CanadianOrca/AV3D/README.md

# AV3D
AV3D or Avid as is our nickname, is an acoustophoretic volumetric display. It will be able to display 3D objects using acoustic radiation forces to levitate and rapidly move a small physical particle. We utilize a fast computer and synchronized LEDs to iterate a Persistence of Vision effect, making the fast bead appear 3D.
