CanadianOrca/AV3D/docs/prototype.md

Notes acquired after testing the prototype. ETA TBD.
