CanadianOrca/AV3D/bom.csv

 |  | USD
Materials List (stuff that we buy) | Amount | Cost | LINK
Pi Zero 2 W Starter Kit with Pre-Soldered Header | 1 | $117.62 | https://www.canakit.com/raspberry-pi-zero-2-w.html?cid=cad&src=raspberrypi
1?20 female header, 2.54 mm PPTC201LFBN-RC | 4 | $3.24 | https://www.digikey.ca/en/products/detail/sullins-connector-solutions/PPTC201LFBN-RC/810158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
Sipeed Tang Nano 20K FPGA board (GW2AR-18), (with soldered pin header) | 3 | $80.02 | https://www.aliexpress.com/item/1005005581148230.html
Mean Well GST160A12-R7B, 12 V 11.5 A 138 W desktop adapter, 4-pin DIN (R7B) output, C14 inlet | 1 | $53.05 | https://www.digikey.ca/en/products/detail/mean-well-usa-inc/GST160A12-R7B/7703599
Mean Well DC-PLUG-R7BF-P1M (R7B to 5.5 ? 2.5 mm plug adapter) | 1 | $1.21 | https://www.digikey.ca/en/products/detail/mean-well-usa-inc/DC-PLUG-R7BF-P1M/12142223
DC jack to screw terminal adapter, 5.5 ? 2.5 mm male/female | 1 | $8.51 | https://www.amazon.ca/20-Connectors-Terminal-Adapter-Security/dp/B0C4JJ2HB4/ref=sr_1_7?sr=8-7
TED-LED 12 pcs 5 x 20 mm inline screw-type fuse holders with 16 AWG wire + fuse kit | 1 | $9.90 | https://www.amazon.ca/Ted-Lele-5x20mm-Holder-Assorted/dp/B07BC8DW3L/ref=sr_1_9?sr=8-9
Phoenix Contact 1715721 (MKDS 1,5/2-5,08), 2-pos 10 A 5.08 mm 2 pin PCB screw terminal, J1 | 2 | $2.37 | https://www.mouser.ca/ProductDetail/Phoenix-Contact/1715721?qs=BYlwlsDsB%2FqgmKyTCSucHg%3D%3D
DC Y-splitter, 5.5 ? 2.5 mm, 10A, 1 female to 2 male | 1 | $4.13 | https://www.aliexpress.com/i/1005012828857964.html
BOJACK T5AL250V, 5 A time-lag 5 x 20 mm slow-blow glass fuses | 1 | $11.35 | https://www.amazon.ca/BOJACK-T5AL250V-5x20mm-Fuses-Time-delay/dp/B07XYWZWV4/ref=sr_1_6?sr=8-6
Nichicon UHE1E471MPD6, 470 æF 25 V electrolytic, 10 mm | 6 | $4.87 | https://www.digikey.ca/en/products/detail/nichicon/UHE1E471MPD6/589294
Amazon basics AC NEMA 5-15P to IEC C13, 6 ft power cord | 1 | $8.95 | https://www.amazon.ca/Amazon-Basics-Computer-Monitor-Replacement/dp/B072BYGKZZ
3W RGB LED 6PIN | 6 | $1.21 | https://www.aliexpress.com/item/1005011863414612.html
Phoenix Contact 1715747 (MKDS 1,5/4-5,08) 4-pin 5.08 mm screw terminal J6 | 1 | $2.33 | https://www.mouser.ca/en/ProductDetail/Phoenix-Contact/1715747
through-hole resistor (Vishay PR02000202709JR500, 27 ê 2 W red, R19) | 2 | $0.88 | https://www.digikey.ca/en/products/detail/vishay-beyschlag-draloric-bc-components/PR02000202709JR500/596160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
through-hole resistor( Vishay PR02000201209JR500, 12 ê 2 W green and blue, R20/R21) | 4 | $1.65 | https://www.digikey.ca/en/products/result?keywords=PR02000201209JR500
Standoffs and M3 screws and nuts | 1 | $12.77 | https://www.amazon.ca/Jucoan-Standoffs-Assortment-Threaded-Motherboard/dp/B08DMSNB8X
Clear plastic shield clear acrylic sheet 2mm | 3 | $14.19 | https://www.amazon.ca/Acrylic-Transparent-Plexiglass-Protective-Projects/dp/B09XR5MR17
Fermerry 22 10ft AWG Hook-up wire, 6 colours each | 1 | $14.41 | https://www.amazon.ca/Fermerry-Stranded-Electric-Tinned-Copper/dp/B089CQHRDT
18 AWG red/black wire | 1 | $12.77 | https://www.amazon.ca/VIABRICO-Electrical-Stranded-Voltage-Extension/dp/B08D6VND2B
Female-to-female jumper wires | 1 | $4.96 | https://www.amazon.ca/Elegoo-120pcs-Multicolored-Breadboard-arduino/dp/B0H6F428L1
Break-away 0.1" 36-pin strip male header (J3, J4, J5, J7, J8) | 1 | $4.93 | https://www.pishop.ca/product/break-away-0-1-36-pin-strip-male-header-10-pieces/
2.54 mm jumper shunt (J7, J8) | 1 | $6.38 | https://www.amazon.ca/MECCANIXITY-2-54mm-Standard-Circuit-Connection/dp/B0BG9VL1SL/ref=sr_1_5?sr=8-5
10mm 40kHz Piezo Ultrasonic Transmitter Manorshi MSO-P1Z1040DH07T (Sound) | 288 | $189.45 | https://www.alibaba.com/product-detail/Manorshi_10mm_40khz_piezo_ultrasonic_Transmitter_Receiver_sensor_60248714908.html
polysterene beads 2-3 mm | 1 | $11.21 | https://www.amazon.ca/PATIKIL-Polystyrene-Supplies-Wedding-Homemade/dp/B0FC2DBFSL/ref=sr_1_2?sr=8-2
PCB | 2 | $350.00 | https://jlcpcb.com/user-center/orderDetails/?batchNum=W2026111010204639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
Total cost in USD |  | $932.30
Recommended Budget: |  | $1,000
