CanadianOrca/AV3D/cad/Hackclubprototype.step

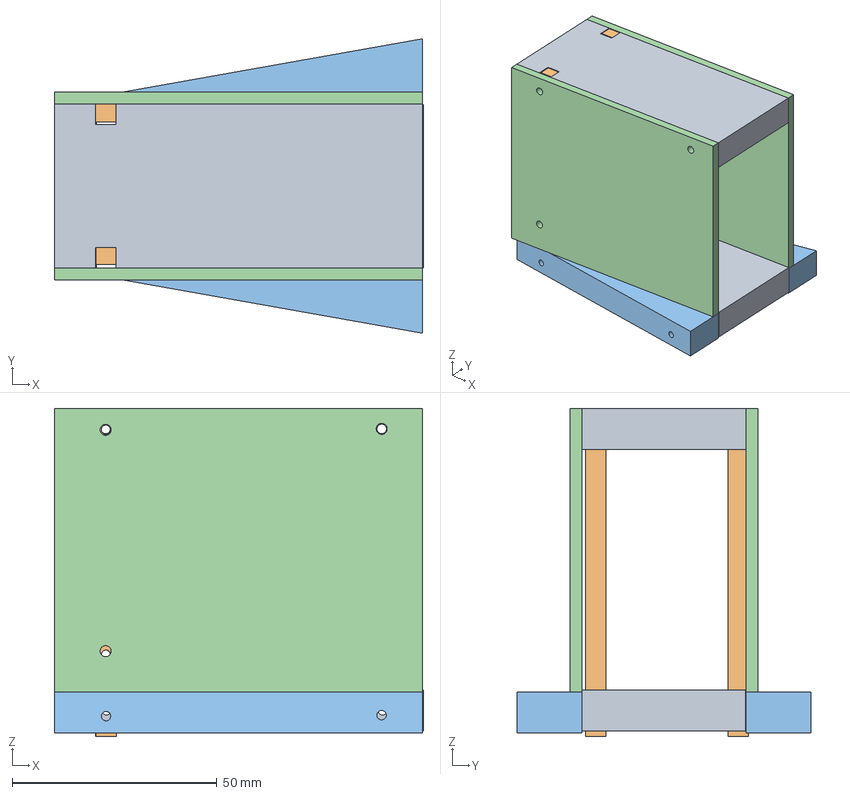
[picture p1: CAD file, 2026-11-12]
cad/Hackclubprototype.step
90.2 x 72.0 x 80.2 mm
