CanadianOrca/AV3D/hardware/kicad/AV3D PC.kicad_pcb

## KiCad design hardware/kicad/AV3D PC.kicad_pcb (2026-11-12)

Schematic: AV3D PCB.kicad_sch

Parts:
A1: Raspberry Pi Zero 2 W; Raspberry_Pi_Zero_Socketed_THT_MountingHoles_SMT
A2: Tang Nano 20K; TangNano20K_2x20
C1, C2, C3, C4, C5, C6, C7, C8, C9, C10, C11, C12, C13, C14, C15, C16, C17, C18, C19, C20, C21, C22, C23, C24, C25, C26, C27, C28, C29, C30, C31, C32, C33, C34, C35, C36, C37, C38, C39, C40, C41, C42, C43, C44, C45, C46, C47, C48, C49, C50, C51, C52, C53, C54, C55, C56, C57, C58, C59, C60, C61, C62, C63, C64, C65, C66, C67, C68, C69, C70, C71, C72, C73, C74, C75, C76, C77, C78, C79, C80, C81, C82, C83, C84, C85, C86, C87, C88, C89, C90, C91, C92, C93, C94, C95, C96, C97, C98, C99, C100, C101, C102, C103, C104, C105, C106, C107, C108, C109, C110, C111, C112, C113, C114, C115, C116, C117, C118, C119, C120, C121, C122, C123, C124, C125, C126, C127, C128, C129, C130, C131, C132, C133, C134, C135, C136, C137, C138, C139, C140, C141, C142, C143, C144: 4.7uF, 35V; C_1206_3216Metric
C145, C146, C147, C148, C149, C150, C151, C152, C153, C154, C155, C156, C157, C158, C159, C160, C161, C162, C163, C164, C165, C166, C167, C168, C169, C170, C171, C172, C173, C174, C175, C176, C177, C178, C179, C180, C181, C182, C183, C184, C185, C186, C187, C188, C189, C190, C191, C192, C193, C194, C195, C196, C197, C198, C199, C200, C201, C202, C203, C204, C205, C206, C207, C208, C209, C210, C211, C212, C213, C214, C215, C216, C217, C218, C219, C220, C221, C222, C223, C224, C225, C226, C227, C228, C229, C230, C231, C232, C233, C234, C235, C236, C237, C238, C239, C240, C241, C242, C243, C244, C245, C246, C247, C248, C249, C250, C251, C252, C253, C254, C255, C256, C257, C258, C259, C260, C261, C262, C263, C264, C265, C266, C267, C268, C269, C270, C271, C272, C273, C274, C275, C276, C277, C278, C279, C280, C281, C282, C283, C284, C285, C286, C287, C288, C289, C290, C291, C292, C293, C294, C295, C296, C297, C298, C299, C300, C301, C302, C303, C304, C305, C306: 0.1uF, 35V; C_0805_2012Metric
D1: 1N5819WS; D_SOD-123
J1: 12V IN; Molex_70555_RA_1x02_P2.54
J2: LED 1 (12V common anode); PinHeader_1x04_P2.54mm_Vertical
J3: LED 2 (12V common anode); PinHeader_1x04_P2.54mm_Vertical
J4: LED 3 (12V common anode); PinHeader_1x04_P2.54mm_Vertical
J5: LED 4 (12V common anode); PinHeader_1x04_P2.54mm_Vertical
J6: BOARD LINK; PinHeader_1x06_P2.54mm_Vertical
J7: 5V IN; PinHeader_1x02_P2.54mm_Vertical
LS1, LS2, LS3, LS4, LS5, LS6, LS7, LS8, LS9, LS10, LS11, LS12, LS13, LS14, LS15, LS16, LS17, LS18, LS19, LS20, LS21, LS22, LS23, LS24, LS25, LS26, LS27, LS28, LS29, LS30, LS31, LS32, LS33, LS34, LS35, LS36, LS37, LS38, LS39, LS40, LS41, LS42, LS43, LS44, LS45, LS46, LS47, LS48, LS49, LS50, LS51, LS52, LS53, LS54, LS55, LS56, LS57, LS58, LS59, LS60, LS61, LS62, LS63, LS64, LS65, LS66, LS67, LS68, LS69, LS70, LS71, LS72, LS73, LS74, LS75, LS76, LS77, LS78, LS79, LS80, LS81, LS82, LS83, LS84, LS85, LS86, LS87, LS88, LS89, LS90, LS91, LS92, LS93, LS94, LS95, LS96, LS97, LS98, LS99, LS100, LS101, LS102, LS103, LS104, LS105, LS106, LS107, LS108, LS109, LS110, LS111, LS112, LS113, LS114, LS115, LS116, LS117, LS118, LS119, LS120, LS121, LS122, LS123, LS124, LS125, LS126, LS127, LS128, LS129, LS130, LS131, LS132, LS133, LS134, LS135, LS136, LS137, LS138, LS139, LS140, LS141, LS142, LS143, LS144: Speaker_Ultrasound; MSO-P1040H07T
Q1, Q2, Q3: AO3400A; SOT-23
R1, R2: 10k; R_0603_1608Metric
R3, R4, R5, R6, R7: 100; R_0603_1608Metric
R8, R9, R10: 100k; R_0603_1608Metric
U1, U2, U3, U4, U5, U6, U7, U8, U9, U10, U11, U12, U13, U14, U15, U16, U17, U18, U19, U20, U21, U22, U23, U24, U25, U26, U27, U28, U29, U30, U31, U32, U33, U34, U35, U36, U37, U38, U39, U40, U41, U42, U43, U44, U45, U46, U47, U48, U49, U50, U51, U52, U53, U54, U55, U56, U57, U58, U59, U60, U61, U62, U63, U64, U65, U66, U67, U68, U69, U70, U71, U72, U73, U74, U75, U76, U77, U78, U79, U80, U81, U82, U83, U84, U85, U86, U87, U88, U89, U90, U91, U92, U93, U94, U95, U96, U97, U98, U99, U100, U101, U102, U103, U104, U105, U106, U107, U108, U109, U110, U111, U112, U113, U114, U115, U116, U117, U118, U119, U120, U121, U122, U123, U124, U125, U126, U127, U128, U129, U130, U131, U132, U133, U134, U135, U136, U137, U138, U139, U140, U141, U142, U143, U144: TC4428A; SO-8_3.9x4.9mm_P1.27mm
U145, U146, U147, U148, U149, U150, U151, U152, U153, U154, U155, U156, U157, U158, U159, U160, U161, U162: 74AHC595; SOIC-16_3.9x9.9mm_P1.27mm

Connections:
+3V3: A2.16 (J5-16 3V3), A2.39 (J6-19 3V3), C289.1, C290.1, C291.1, C292.1, C293.1, C294.1, C295.1, C296.1, C297.1, C298.1, C299.1, C300.1, C301.1, C302.1, C303.1, C304.1, C305.1, C306.1, R1.1, R2.1, U145.10 (~SRCLR), U145.16 (VCC), U146.10 (~SRCLR), U146.16 (VCC), U147.10 (~SRCLR), U147.16 (VCC), U148.10 (~SRCLR), U148.16 (VCC), U149.10 (~SRCLR), U149.16 (VCC), U150.10 (~SRCLR), U150.16 (VCC), U151.10 (~SRCLR), U151.16 (VCC), U152.10 (~SRCLR), U152.16 (VCC), U153.10 (~SRCLR), U153.16 (VCC), U154.10 (~SRCLR), U154.16 (VCC), U155.10 (~SRCLR), U155.16 (VCC), U156.10 (~SRCLR), U156.16 (VCC), U157.10 (~SRCLR), U157.16 (VCC), U158.10 (~SRCLR), U158.16 (VCC), U159.10 (~SRCLR), U159.16 (VCC), U160.10 (~SRCLR), U160.16 (VCC), U161.10 (~SRCLR), U161.16 (VCC), U162.10 (~SRCLR), U162.16 (VCC)
+5V: A1.2 (5V), A1.4 (5V), D1.2 (A), J7.1
+5V_TANG: A2.1 (J5-1 5V), D1.1 (K)
+12V: C1.1, C2.1, C3.1, C4.1, C5.1, C6.1, C7.1, C8.1, C9.1, C10.1, C11.1, C12.1, C13.1, C14.1, C15.1, C16.1, C17.1, C18.1, C19.1, C20.1, C21.1, C22.1, C23.1, C24.1, C25.1, C26.1, C27.1, C28.1, C29.1, C30.1, C31.1, C32.1, C33.1, C34.1, C35.1, C36.1, C37.1, C38.1, C39.1, C40.1, C41.1, C42.1, C43.1, C44.1, C45.1, C46.1, C47.1, C48.1, C49.1, C50.1, C51.1, C52.1, C53.1, C54.1, C55.1, C56.1, C57.1, C58.1, C59.1, C60.1, C61.1, C62.1, C63.1, C64.1, C65.1, C66.1, C67.1, C68.1, C69.1, C70.1, C71.1, C72.1, C73.1, C74.1, C75.1, C76.1, C77.1, C78.1, C79.1, C80.1, C81.1, C82.1, C83.1, C84.1, C85.1, C86.1, C87.1, C88.1, C89.1, C90.1, C91.1, C92.1, C93.1, C94.1, C95.1, C96.1, C97.1, C98.1, C99.1, C100.1, C101.1, C102.1, C103.1, C104.1, C105.1, C106.1, C107.1, C108.1, C109.1, C110.1, C111.1, C112.1, C113.1, C114.1, C115.1, C116.1, C117.1, C118.1, C119.1, C120.1, C121.1, C122.1, C123.1, C124.1, C125.1, C126.1, C127.1, C128.1, C129.1, C130.1, C131.1, C132.1, C133.1, C134.1, C135.1, C136.1, C137.1, C138.1, C139.1, C140.1, C141.1, C142.1, C143.1, C144.1, C145.1, C146.1, C147.1, C148.1, C149.1, C150.1, C151.1, C152.1, C153.1, C154.1, C155.1, C156.1, C157.1, C158.1, C159.1, C160.1, C161.1, C162.1, C163.1, C164.1, C165.1, C166.1, C167.1, C168.1, C169.1, C170.1, C171.1, C172.1, C173.1, C174.1, C175.1, C176.1, C177.1, C178.1, C179.1, C180.1, C181.1, C182.1, C183.1, C184.1, C185.1, C186.1, C187.1, C188.1, C189.1, C190.1, C191.1, C192.1, C193.1, C194.1, C195.1, C196.1, C197.1, C198.1, C199.1, C200.1, C201.1, C202.1, C203.1, C204.1, C205.1, C206.1, C207.1, C208.1, C209.1, C210.1, C211.1, C212.1, C213.1, C214.1, C215.1, C216.1, C217.1, C218.1, C219.1, C220.1, C221.1, C222.1, C223.1, C224.1, C225.1, C226.1, C227.1, C228.1, C229.1, C230.1, C231.1, C232.1, C233.1, C234.1, C235.1, C236.1, C237.1, C238.1, C239.1, C240.1, C241.1, C242.1, C243.1, C244.1, C245.1, C246.1, C247.1, C248.1, C249.1, C250.1, C251.1, C252.1, C253.1, C254.1, C255.1, C256.1, C257.1, C258.1, C259.1, C260.1, C261.1, C262.1, C263.1, C264.1, C265.1, C266.1, C267.1, C268.1, C269.1, C270.1, C271.1, C272.1, C273.1, C274.1, C275.1, C276.1, C277.1, C278.1, C279.1, C280.1, C281.1, C282.1, C283.1, C284.1, C285.1, C286.1, C287.1, C288.1, J1.1, J2.1, J3.1, J4.1, J5.1, U1.6 (VDD), U2.6 (VDD), U3.6 (VDD), U4.6 (VDD), U5.6 (VDD), U6.6 (VDD), U7.6 (VDD), U8.6 (VDD), U9.6 (VDD), U10.6 (VDD), U11.6 (VDD), U12.6 (VDD), U13.6 (VDD), U14.6 (VDD), U15.6 (VDD), U16.6 (VDD), U17.6 (VDD), U18.6 (VDD), U19.6 (VDD), U20.6 (VDD), U21.6 (VDD), U22.6 (VDD), U23.6 (VDD), U24.6 (VDD), U25.6 (VDD), U26.6 (VDD), U27.6 (VDD), U28.6 (VDD), U29.6 (VDD), U30.6 (VDD), U31.6 (VDD), U32.6 (VDD), U33.6 (VDD), U34.6 (VDD), U35.6 (VDD), U36.6 (VDD), U37.6 (VDD), U38.6 (VDD), U39.6 (VDD), U40.6 (VDD), U41.6 (VDD), U42.6 (VDD), U43.6 (VDD), U44.6 (VDD), U45.6 (VDD), U46.6 (VDD), U47.6 (VDD), U48.6 (VDD), U49.6 (VDD), U50.6 (VDD), U51.6 (VDD), U52.6 (VDD), U53.6 (VDD), U54.6 (VDD), U55.6 (VDD), U56.6 (VDD), U57.6 (VDD), U58.6 (VDD), U59.6 (VDD), U60.6 (VDD), U61.6 (VDD), U62.6 (VDD), U63.6 (VDD), U64.6 (VDD), U65.6 (VDD), U66.6 (VDD), U67.6 (VDD), U68.6 (VDD), U69.6 (VDD), U70.6 (VDD), U71.6 (VDD), U72.6 (VDD), U73.6 (VDD), U74.6 (VDD), U75.6 (VDD), U76.6 (VDD), U77.6 (VDD), U78.6 (VDD), U79.6 (VDD), U80.6 (VDD), U81.6 (VDD), U82.6 (VDD), U83.6 (VDD), U84.6 (VDD), U85.6 (VDD), U86.6 (VDD), U87.6 (VDD), U88.6 (VDD), U89.6 (VDD), U90.6 (VDD), U91.6 (VDD), U92.6 (VDD), U93.6 (VDD), U94.6 (VDD), U95.6 (VDD), U96.6 (VDD), U97.6 (VDD), U98.6 (VDD), U99.6 (VDD), U100.6 (VDD), U101.6 (VDD), U102.6 (VDD), U103.6 (VDD), U104.6 (VDD), U105.6 (VDD), U106.6 (VDD), U107.6 (VDD), U108.6 (VDD), U109.6 (VDD), U110.6 (VDD), U111.6 (VDD), U112.6 (VDD), U113.6 (VDD), U114.6 (VDD), U115.6 (VDD), U116.6 (VDD), U117.6 (VDD), U118.6 (VDD), U119.6 (VDD), U120.6 (VDD), U121.6 (VDD), U122.6 (VDD), U123.6 (VDD), U124.6 (VDD), U125.6 (VDD), U126.6 (VDD), U127.6 (VDD), U128.6 (VDD), U129.6 (VDD), U130.6 (VDD), U131.6 (VDD), U132.6 (VDD), U133.6 (VDD), U134.6 (VDD), U135.6 (VDD), U136.6 (VDD), U137.6 (VDD), U138.6 (VDD), U139.6 (VDD), U140.6 (VDD), U141.6 (VDD), U142.6 (VDD), U143.6 (VDD), U144.6 (VDD)
CH1: U1.2 (INA), U1.4 (INB), U145.15 (QA)
CH2: U2.2 (INA), U2.4 (INB), U145.1 (QB)
CH3: U3.2 (INA), U3.4 (INB), U145.2 (QC)
CH4: U4.2 (INA), U4.4 (INB), U145.3 (QD)
CH5: U5.2 (INA), U5.4 (INB), U145.4 (QE)
CH6: U6.2 (INA), U6.4 (INB), U145.5 (QF)
CH7: U7.2 (INA), U7.4 (INB), U145.6 (QG)
CH8: U8.2 (INA), U8.4 (INB), U145.7 (QH)
CH9: U9.2 (INA), U9.4 (INB), U146.15 (QA)
CH10: U10.2 (INA), U10.4 (INB), U146.1 (QB)
CH11: U11.2 (INA), U11.4 (INB), U146.2 (QC)
CH12: U12.2 (INA), U12.4 (INB), U146.3 (QD)
CH13: U13.2 (INA), U13.4 (INB), U146.4 (QE)
CH14: U14.2 (INA), U14.4 (INB), U146.5 (QF)
CH15: U15.2 (INA), U15.4 (INB), U146.6 (QG)
CH16: U16.2 (INA), U16.4 (INB), U146.7 (QH)
CH17: U17.2 (INA), U17.4 (INB), U147.15 (QA)
CH18: U18.2 (INA), U18.4 (INB), U147.1 (QB)
CH19: U19.2 (INA), U19.4 (INB), U147.2 (QC)
CH20: U20.2 (INA), U20.4 (INB), U147.3 (QD)
CH21: U21.2 (INA), U21.4 (INB), U147.4 (QE)
CH22: U22.2 (INA), U22.4 (INB), U147.5 (QF)
CH23: U23.2 (INA), U23.4 (INB), U147.6 (QG)
CH24: U24.2 (INA), U24.4 (INB), U147.7 (QH)
CH25: U25.2 (INA), U25.4 (INB), U148.15 (QA)
CH26: U26.2 (INA), U26.4 (INB), U148.1 (QB)
CH27: U27.2 (INA), U27.4 (INB), U148.2 (QC)
CH28: U28.2 (INA), U28.4 (INB), U148.3 (QD)
CH29: U29.2 (INA), U29.4 (INB), U148.4 (QE)
CH30: U30.2 (INA), U30.4 (INB), U148.5 (QF)
CH31: U31.2 (INA), U31.4 (INB), U148.6 (QG)
CH32: U32.2 (INA), U32.4 (INB), U148.7 (QH)
CH33: U33.2 (INA), U33.4 (INB), U149.15 (QA)
CH34: U34.2 (INA), U34.4 (INB), U149.1 (QB)
CH35: U35.2 (INA), U35.4 (INB), U149.2 (QC)
CH36: U36.2 (INA), U36.4 (INB), U149.3 (QD)
CH37: U37.2 (INA), U37.4 (INB), U149.4 (QE)
CH38: U38.2 (INA), U38.4 (INB), U149.5 (QF)
CH39: U39.2 (INA), U39.4 (INB), U149.6 (QG)
CH40: U40.2 (INA), U40.4 (INB), U149.7 (QH)
CH41: U41.2 (INA), U41.4 (INB), U150.15 (QA)
CH42: U42.2 (INA), U42.4 (INB), U150.1 (QB)
CH43: U43.2 (INA), U43.4 (INB), U150.2 (QC)
CH44: U44.2 (INA), U44.4 (INB), U150.3 (QD)
CH45: U45.2 (INA), U45.4 (INB), U150.4 (QE)
CH46: U46.2 (INA), U46.4 (INB), U150.5 (QF)
CH47: U47.2 (INA), U47.4 (INB), U150.6 (QG)
CH48: U48.2 (INA), U48.4 (INB), U150.7 (QH)
CH49: U49.2 (INA), U49.4 (INB), U151.15 (QA)
CH50: U50.2 (INA), U50.4 (INB), U151.1 (QB)
CH51: U51.2 (INA), U51.4 (INB), U151.2 (QC)
CH52: U52.2 (INA), U52.4 (INB), U151.3 (QD)
CH53: U53.2 (INA), U53.4 (INB), U151.4 (QE)
CH54: U54.2 (INA), U54.4 (INB), U151.5 (QF)
CH55: U55.2 (INA), U55.4 (INB), U151.6 (QG)
CH56: U56.2 (INA), U56.4 (INB), U151.7 (QH)
CH57: U57.2 (INA), U57.4 (INB), U152.15 (QA)
CH58: U58.2 (INA), U58.4 (INB), U152.1 (QB)
CH59: U59.2 (INA), U59.4 (INB), U152.2 (QC)
CH60: U60.2 (INA), U60.4 (INB), U152.3 (QD)
CH61: U61.2 (INA), U61.4 (INB), U152.4 (QE)
CH62: U62.2 (INA), U62.4 (INB), U152.5 (QF)
CH63: U63.2 (INA), U63.4 (INB), U152.6 (QG)
CH64: U64.2 (INA), U64.4 (INB), U152.7 (QH)
CH65: U65.2 (INA), U65.4 (INB), U153.15 (QA)
CH66: U66.2 (INA), U66.4 (INB), U153.1 (QB)
CH67: U67.2 (INA), U67.4 (INB), U153.2 (QC)
CH68: U68.2 (INA), U68.4 (INB), U153.3 (QD)
CH69: U69.2 (INA), U69.4 (INB), U153.4 (QE)
CH70: U70.2 (INA), U70.4 (INB), U153.5 (QF)
CH71: U71.2 (INA), U71.4 (INB), U153.6 (QG)
CH72: U72.2 (INA), U72.4 (INB), U153.7 (QH)
CH73: U73.2 (INA), U73.4 (INB), U154.15 (QA)
CH74: U74.2 (INA), U74.4 (INB), U154.1 (QB)
CH75: U75.2 (INA), U75.4 (INB), U154.2 (QC)
CH76: U76.2 (INA), U76.4 (INB), U154.3 (QD)
CH77: U77.2 (INA), U77.4 (INB), U154.4 (QE)
CH78: U78.2 (INA), U78.4 (INB), U154.5 (QF)
CH79: U79.2 (INA), U79.4 (INB), U154.6 (QG)
CH80: U80.2 (INA), U80.4 (INB), U154.7 (QH)
CH81: U81.2 (INA), U81.4 (INB), U155.15 (QA)
CH82: U82.2 (INA), U82.4 (INB), U155.1 (QB)
CH83: U83.2 (INA), U83.4 (INB), U155.2 (QC)
CH84: U84.2 (INA), U84.4 (INB), U155.3 (QD)
CH85: U85.2 (INA), U85.4 (INB), U155.4 (QE)
CH86: U86.2 (INA), U86.4 (INB), U155.5 (QF)
CH87: U87.2 (INA), U87.4 (INB), U155.6 (QG)
CH88: U88.2 (INA), U88.4 (INB), U155.7 (QH)
CH89: U89.2 (INA), U89.4 (INB), U156.15 (QA)
CH90: U90.2 (INA), U90.4 (INB), U156.1 (QB)
CH91: U91.2 (INA), U91.4 (INB), U156.2 (QC)
CH92: U92.2 (INA), U92.4 (INB), U156.3 (QD)
CH93: U93.2 (INA), U93.4 (INB), U156.4 (QE)
CH94: U94.2 (INA), U94.4 (INB), U156.5 (QF)
CH95: U95.2 (INA), U95.4 (INB), U156.6 (QG)
CH96: U96.2 (INA), U96.4 (INB), U156.7 (QH)
CH97: U97.2 (INA), U97.4 (INB), U157.15 (QA)
CH98: U98.2 (INA), U98.4 (INB), U157.1 (QB)
CH99: U99.2 (INA), U99.4 (INB), U157.2 (QC)
CH100: U100.2 (INA), U100.4 (INB), U157.3 (QD)
CH101: U101.2 (INA), U101.4 (INB), U157.4 (QE)
CH102: U102.2 (INA), U102.4 (INB), U157.5 (QF)
CH103: U103.2 (INA), U103.4 (INB), U157.6 (QG)
CH104: U104.2 (INA), U104.4 (INB), U157.7 (QH)
CH105: U105.2 (INA), U105.4 (INB), U158.15 (QA)
CH106: U106.2 (INA), U106.4 (INB), U158.1 (QB)
CH107: U107.2 (INA), U107.4 (INB), U158.2 (QC)
CH108: U108.2 (INA), U108.4 (INB), U158.3 (QD)
CH109: U109.2 (INA), U109.4 (INB), U158.4 (QE)
CH110: U110.2 (INA), U110.4 (INB), U158.5 (QF)
CH111: U111.2 (INA), U111.4 (INB), U158.6 (QG)
CH112: U112.2 (INA), U112.4 (INB), U158.7 (QH)
CH113: U113.2 (INA), U113.4 (INB), U159.15 (QA)
CH114: U114.2 (INA), U114.4 (INB), U159.1 (QB)
CH115: U115.2 (INA), U115.4 (INB), U159.2 (QC)
CH116: U116.2 (INA), U116.4 (INB), U159.3 (QD)
CH117: U117.2 (INA), U117.4 (INB), U159.4 (QE)
CH118: U118.2 (INA), U118.4 (INB), U159.5 (QF)
CH119: U119.2 (INA), U119.4 (INB), U159.6 (QG)
CH120: U120.2 (INA), U120.4 (INB), U159.7 (QH)
CH121: U121.2 (INA), U121.4 (INB), U160.15 (QA)
CH122: U122.2 (INA), U122.4 (INB), U160.1 (QB)
CH123: U123.2 (INA), U123.4 (INB), U160.2 (QC)
CH124: U124.2 (INA), U124.4 (INB), U160.3 (QD)
CH125: U125.2 (INA), U125.4 (INB), U160.4 (QE)
CH126: U126.2 (INA), U126.4 (INB), U160.5 (QF)
CH127: U127.2 (INA), U127.4 (INB), U160.6 (QG)
CH128: U128.2 (INA), U128.4 (INB), U160.7 (QH)
CH129: U129.2 (INA), U129.4 (INB), U161.15 (QA)
CH130: U130.2 (INA), U130.4 (INB), U161.1 (QB)
CH131: U131.2 (INA), U131.4 (INB), U161.2 (QC)
CH132: U132.2 (INA), U132.4 (INB), U161.3 (QD)
CH133: U133.2 (INA), U133.4 (INB), U161.4 (QE)
CH134: U134.2 (INA), U134.4 (INB), U161.5 (QF)
CH135: U135.2 (INA), U135.4 (INB), U161.6 (QG)
CH136: U136.2 (INA), U136.4 (INB), U161.7 (QH)
CH137: U137.2 (INA), U137.4 (INB), U162.15 (QA)
CH138: U138.2 (INA), U138.4 (INB), U162.1 (QB)
CH139: U139.2 (INA), U139.4 (INB), U162.2 (QC)
CH140: U140.2 (INA), U140.4 (INB), U162.3 (QD)
CH141: U141.2 (INA), U141.4 (INB), U162.4 (QE)
CH142: U142.2 (INA), U142.4 (INB), U162.5 (QF)
CH143: U143.2 (INA), U143.4 (INB), U162.6 (QG)
CH144: U144.2 (INA), U144.4 (INB), U162.7 (QH)
GATE_B: Q3.1 (G), R7.2, R10.1
GATE_G: Q2.1 (G), R6.2, R9.1
GATE_R: Q1.1 (G), R5.2, R8.1
GND: A1.6 (GND), A1.9 (GND), A1.14 (GND), A1.20 (GND), A1.25 (GND), A1.30 (GND), A1.34 (GND), A1.39 (GND), A2.2 (J5-2 GND), A2.15 (J5-15 GND), A2.40 (J6-20 GND), C1.2, C2.2, C3.2, C4.2, C5.2, C6.2, C7.2, C8.2, C9.2, C10.2, C11.2, C12.2, C13.2, C14.2, C15.2, C16.2, C17.2, C18.2, C19.2, C20.2, C21.2, C22.2, C23.2, C24.2, C25.2, C26.2, C27.2, C28.2, C29.2, C30.2, C31.2, C32.2, C33.2, C34.2, C35.2, C36.2, C37.2, C38.2, C39.2, C40.2, C41.2, C42.2, C43.2, C44.2, C45.2, C46.2, C47.2, C48.2, C49.2, C50.2, C51.2, C52.2, C53.2, C54.2, C55.2, C56.2, C57.2, C58.2, C59.2, C60.2, C61.2, C62.2, C63.2, C64.2, C65.2, C66.2, C67.2, C68.2, C69.2, C70.2, C71.2, C72.2, C73.2, C74.2, C75.2, C76.2, C77.2, C78.2, C79.2, C80.2, C81.2, C82.2, C83.2, C84.2, C85.2, C86.2, C87.2, C88.2, C89.2, C90.2, C91.2, C92.2, C93.2, C94.2, C95.2, C96.2, C97.2, C98.2, C99.2, C100.2, C101.2, C102.2, C103.2, C104.2, C105.2, C106.2, C107.2, C108.2, C109.2, C110.2, C111.2, C112.2, C113.2, C114.2, C115.2, C116.2, C117.2, C118.2, C119.2, C120.2, C121.2, C122.2, C123.2, C124.2, C125.2, C126.2, C127.2, C128.2, C129.2, C130.2, C131.2, C132.2, C133.2, C134.2, C135.2, C136.2, C137.2, C138.2, C139.2, C140.2, C141.2, C142.2, C143.2, C144.2, C145.2, C146.2, C147.2, C148.2, C149.2, C150.2, C151.2, C152.2, C153.2, C154.2, C155.2, C156.2, C157.2, C158.2, C159.2, C160.2, C161.2, C162.2, C163.2, C164.2, C165.2, C166.2, C167.2, C168.2, C169.2, C170.2, C171.2, C172.2, C173.2, C174.2, C175.2, C176.2, C177.2, C178.2, C179.2, C180.2, C181.2, C182.2, C183.2, C184.2, C185.2, C186.2, C187.2, C188.2, C189.2, C190.2, C191.2, C192.2, C193.2, C194.2, C195.2, C196.2, C197.2, C198.2, C199.2, C200.2, C201.2, C202.2, C203.2, C204.2, C205.2, C206.2, C207.2, C208.2, C209.2, C210.2, C211.2, C212.2, C213.2, C214.2, C215.2, C216.2, C217.2, C218.2, C219.2, C220.2, C221.2, C222.2, C223.2, C224.2, C225.2, C226.2, C227.2, C228.2, C229.2, C230.2, C231.2, C232.2, C233.2, C234.2, C235.2, C236.2, C237.2, C238.2, C239.2, C240.2, C241.2, C242.2, C243.2, C244.2, C245.2, C246.2, C247.2, C248.2, C249.2, C250.2, C251.2, C252.2, C253.2, C254.2, C255.2, C256.2, C257.2, C258.2, C259.2, C260.2, C261.2, C262.2, C263.2, C264.2, C265.2, C266.2, C267.2, C268.2, C269.2, C270.2, C271.2, C272.2, C273.2, C274.2, C275.2, C276.2, C277.2, C278.2, C279.2, C280.2, C281.2, C282.2, C283.2, C284.2, C285.2, C286.2, C287.2, C288.2, C289.2, C290.2, C291.2, C292.2, C293.2, C294.2, C295.2, C296.2, C297.2, C298.2, C299.2, C300.2, C301.2, C302.2, C303.2, C304.2, C305.2, C306.2, J1.2, J6.6, J7.2, Q1.2 (S), Q2.2 (S), Q3.2 (S), R8.2, R9.2, R10.2, U1.3 (GND), U2.3 (GND), U3.3 (GND), U4.3 (GND), U5.3 (GND), U6.3 (GND), U7.3 (GND), U8.3 (GND), U9.3 (GND), U10.3 (GND), U11.3 (GND), U12.3 (GND), U13.3 (GND), U14.3 (GND), U15.3 (GND), U16.3 (GND), U17.3 (GND), U18.3 (GND), U19.3 (GND), U20.3 (GND), U21.3 (GND), U22.3 (GND), U23.3 (GND), U24.3 (GND), U25.3 (GND), U26.3 (GND), U27.3 (GND), U28.3 (GND), U29.3 (GND), U30.3 (GND), U31.3 (GND), U32.3 (GND), U33.3 (GND), U34.3 (GND), U35.3 (GND), U36.3 (GND), U37.3 (GND), U38.3 (GND), U39.3 (GND), U40.3 (GND), U41.3 (GND), U42.3 (GND), U43.3 (GND), U44.3 (GND), U45.3 (GND), U46.3 (GND), U47.3 (GND), U48.3 (GND), U49.3 (GND), U50.3 (GND), U51.3 (GND), U52.3 (GND), U53.3 (GND), U54.3 (GND), U55.3 (GND), U56.3 (GND), U57.3 (GND), U58.3 (GND), U59.3 (GND), U60.3 (GND), U61.3 (GND), U62.3 (GND), U63.3 (GND), U64.3 (GND), U65.3 (GND), U66.3 (GND), U67.3 (GND), U68.3 (GND), U69.3 (GND), U70.3 (GND), U71.3 (GND), U72.3 (GND), U73.3 (GND), U74.3 (GND), U75.3 (GND), U76.3 (GND), U77.3 (GND), U78.3 (GND), U79.3 (GND), U80.3 (GND), U81.3 (GND), U82.3 (GND), U83.3 (GND), U84.3 (GND), U85.3 (GND), U86.3 (GND), U87.3 (GND), U88.3 (GND), U89.3 (GND), U90.3 (GND), U91.3 (GND), U92.3 (GND), U93.3 (GND), U94.3 (GND), U95.3 (GND), U96.3 (GND), U97.3 (GND), U98.3 (GND), U99.3 (GND), U100.3 (GND), U101.3 (GND), U102.3 (GND), U103.3 (GND), U104.3 (GND), U105.3 (GND), U106.3 (GND), U107.3 (GND), U108.3 (GND), U109.3 (GND), U110.3 (GND), U111.3 (GND), U112.3 (GND), U113.3 (GND), U114.3 (GND), U115.3 (GND), U116.3 (GND), U117.3 (GND), U118.3 (GND), U119.3 (GND), U120.3 (GND), U121.3 (GND), U122.3 (GND), U123.3 (GND), U124.3 (GND), U125.3 (GND), U126.3 (GND), U127.3 (GND), U128.3 (GND), U129.3 (GND), U130.3 (GND), U131.3 (GND), U132.3 (GND), U133.3 (GND), U134.3 (GND), U135.3 (GND), U136.3 (GND), U137.3 (GND), U138.3 (GND), U139.3 (GND), U140.3 (GND), U141.3 (GND), U142.3 (GND), U143.3 (GND), U144.3 (GND), U145.8 (GND), U145.13 (~OE), U146.8 (GND), U146.13 (~OE), U147.8 (GND), U147.13 (~OE), U148.8 (GND), U148.13 (~OE), U149.8 (GND), U149.13 (~OE), U150.8 (GND), U150.13 (~OE), U151.8 (GND), U151.13 (~OE), U152.8 (GND), U152.13 (~OE), U153.8 (GND), U153.13 (~OE), U154.8 (GND), U154.13 (~OE), U155.8 (GND), U155.13 (~OE), U156.8 (GND), U156.13 (~OE), U157.8 (GND), U157.13 (~OE), U158.8 (GND), U158.13 (~OE), U159.8 (GND), U159.13 (~OE), U160.8 (GND), U160.13 (~OE), U161.8 (GND), U161.13 (~OE), U162.8 (GND), U162.13 (~OE)
LEDK_B: J2.4, J3.4, J4.4, J5.4, Q3.3 (D)
LEDK_G: J2.3, J3.3, J4.3, J5.3, Q2.3 (D)
LEDK_R: J2.2, J3.2, J4.2, J5.2, Q1.3 (D)
LED_B: A2.9 (J5-9 IO51), R7.1
LED_G: A2.12 (J5-12 IO49), R6.1
LED_R: A2.10 (J5-10 IO48), R5.1
NEXT: A2.34 (J6-14 IO31), R4.1
NEXT_LINK: J6.5, R4.2
OUT1_1: LS1.1, U1.7 (OUTA)
OUT1_2: LS1.2, U1.5 (OUTB)
OUT2_1: LS2.1, U2.7 (OUTA)
OUT2_2: LS2.2, U2.5 (OUTB)
OUT3_1: LS3.1, U3.7 (OUTA)
OUT3_2: LS3.2, U3.5 (OUTB)
OUT4_1: LS4.1, U4.7 (OUTA)
OUT4_2: LS4.2, U4.5 (OUTB)
OUT5_1: LS5.1, U5.7 (OUTA)
OUT5_2: LS5.2, U5.5 (OUTB)
OUT6_1: LS6.1, U6.7 (OUTA)
OUT6_2: LS6.2, U6.5 (OUTB)
OUT7_1: LS7.1, U7.7 (OUTA)
OUT7_2: LS7.2, U7.5 (OUTB)
OUT8_1: LS8.1, U8.7 (OUTA)
OUT8_2: LS8.2, U8.5 (OUTB)
OUT9_1: LS9.1, U9.7 (OUTA)
OUT9_2: LS9.2, U9.5 (OUTB)
OUT10_1: LS10.1, U10.7 (OUTA)
OUT10_2: LS10.2, U10.5 (OUTB)
OUT11_1: LS11.1, U11.7 (OUTA)
OUT11_2: LS11.2, U11.5 (OUTB)
OUT12_1: LS12.1, U12.7 (OUTA)
OUT12_2: LS12.2, U12.5 (OUTB)
OUT13_1: LS13.1, U13.7 (OUTA)
OUT13_2: LS13.2, U13.5 (OUTB)
OUT14_1: LS14.1, U14.7 (OUTA)
OUT14_2: LS14.2, U14.5 (OUTB)
OUT15_1: LS15.1, U15.7 (OUTA)
OUT15_2: LS15.2, U15.5 (OUTB)
OUT16_1: LS16.1, U16.7 (OUTA)
OUT16_2: LS16.2, U16.5 (OUTB)
OUT17_1: LS17.1, U17.7 (OUTA)
OUT17_2: LS17.2, U17.5 (OUTB)
OUT18_1: LS18.1, U18.7 (OUTA)
OUT18_2: LS18.2, U18.5 (OUTB)
OUT19_1: LS19.1, U19.7 (OUTA)
OUT19_2: LS19.2, U19.5 (OUTB)
OUT20_1: LS20.1, U20.7 (OUTA)
OUT20_2: LS20.2, U20.5 (OUTB)
OUT21_1: LS21.1, U21.7 (OUTA)
OUT21_2: LS21.2, U21.5 (OUTB)
OUT22_1: LS22.1, U22.7 (OUTA)
OUT22_2: LS22.2, U22.5 (OUTB)
OUT23_1: LS23.1, U23.7 (OUTA)
OUT23_2: LS23.2, U23.5 (OUTB)
OUT24_1: LS24.1, U24.7 (OUTA)
OUT24_2: LS24.2, U24.5 (OUTB)
OUT25_1: LS25.1, U25.7 (OUTA)
OUT25_2: LS25.2, U25.5 (OUTB)
OUT26_1: LS26.1, U26.7 (OUTA)
OUT26_2: LS26.2, U26.5 (OUTB)
OUT27_1: LS27.1, U27.7 (OUTA)
OUT27_2: LS27.2, U27.5 (OUTB)
OUT28_1: LS28.1, U28.7 (OUTA)
OUT28_2: LS28.2, U28.5 (OUTB)
OUT29_1: LS29.1, U29.7 (OUTA)
OUT29_2: LS29.2, U29.5 (OUTB)
OUT30_1: LS30.1, U30.7 (OUTA)
OUT30_2: LS30.2, U30.5 (OUTB)
OUT31_1: LS31.1, U31.7 (OUTA)
OUT31_2: LS31.2, U31.5 (OUTB)
OUT32_1: LS32.1, U32.7 (OUTA)
OUT32_2: LS32.2, U32.5 (OUTB)
OUT33_1: LS33.1, U33.7 (OUTA)
OUT33_2: LS33.2, U33.5 (OUTB)
OUT34_1: LS34.1, U34.7 (OUTA)
OUT34_2: LS34.2, U34.5 (OUTB)
OUT35_1: LS35.1, U35.7 (OUTA)
OUT35_2: LS35.2, U35.5 (OUTB)
OUT36_1: LS36.1, U36.7 (OUTA)
OUT36_2: LS36.2, U36.5 (OUTB)
OUT37_1: LS37.1, U37.7 (OUTA)
OUT37_2: LS37.2, U37.5 (OUTB)
OUT38_1: LS38.1, U38.7 (OUTA)
OUT38_2: LS38.2, U38.5 (OUTB)
OUT39_1: LS39.1, U39.7 (OUTA)
OUT39_2: LS39.2, U39.5 (OUTB)
OUT40_1: LS40.1, U40.7 (OUTA)
OUT40_2: LS40.2, U40.5 (OUTB)
OUT41_1: LS41.1, U41.7 (OUTA)
OUT41_2: LS41.2, U41.5 (OUTB)
OUT42_1: LS42.1, U42.7 (OUTA)
OUT42_2: LS42.2, U42.5 (OUTB)
OUT43_1: LS43.1, U43.7 (OUTA)
OUT43_2: LS43.2, U43.5 (OUTB)
OUT44_1: LS44.1, U44.7 (OUTA)
OUT44_2: LS44.2, U44.5 (OUTB)
OUT45_1: LS45.1, U45.7 (OUTA)
OUT45_2: LS45.2, U45.5 (OUTB)
OUT46_1: LS46.1, U46.7 (OUTA)
OUT46_2: LS46.2, U46.5 (OUTB)
OUT47_1: LS47.1, U47.7 (OUTA)
OUT47_2: LS47.2, U47.5 (OUTB)
OUT48_1: LS48.1, U48.7 (OUTA)
OUT48_2: LS48.2, U48.5 (OUTB)
OUT49_1: LS49.1, U49.7 (OUTA)
OUT49_2: LS49.2, U49.5 (OUTB)
OUT50_1: LS50.1, U50.7 (OUTA)
OUT50_2: LS50.2, U50.5 (OUTB)
OUT51_1: LS51.1, U51.7 (OUTA)
OUT51_2: LS51.2, U51.5 (OUTB)
OUT52_1: LS52.1, U52.7 (OUTA)
OUT52_2: LS52.2, U52.5 (OUTB)
OUT53_1: LS53.1, U53.7 (OUTA)
OUT53_2: LS53.2, U53.5 (OUTB)
OUT54_1: LS54.1, U54.7 (OUTA)
OUT54_2: LS54.2, U54.5 (OUTB)
OUT55_1: LS55.1, U55.7 (OUTA)
OUT55_2: LS55.2, U55.5 (OUTB)
OUT56_1: LS56.1, U56.7 (OUTA)
OUT56_2: LS56.2, U56.5 (OUTB)
OUT57_1: LS57.1, U57.7 (OUTA)
OUT57_2: LS57.2, U57.5 (OUTB)
OUT58_1: LS58.1, U58.7 (OUTA)
OUT58_2: LS58.2, U58.5 (OUTB)
OUT59_1: LS59.1, U59.7 (OUTA)
OUT59_2: LS59.2, U59.5 (OUTB)
OUT60_1: LS60.1, U60.7 (OUTA)
OUT60_2: LS60.2, U60.5 (OUTB)
OUT61_1: LS61.1, U61.7 (OUTA)
OUT61_2: LS61.2, U61.5 (OUTB)
OUT62_1: LS62.1, U62.7 (OUTA)
OUT62_2: LS62.2, U62.5 (OUTB)
OUT63_1: LS63.1, U63.7 (OUTA)
OUT63_2: LS63.2, U63.5 (OUTB)
OUT64_1: LS64.1, U64.7 (OUTA)
OUT64_2: LS64.2, U64.5 (OUTB)
OUT65_1: LS65.1, U65.7 (OUTA)
OUT65_2: LS65.2, U65.5 (OUTB)
OUT66_1: LS66.1, U66.7 (OUTA)
OUT66_2: LS66.2, U66.5 (OUTB)
OUT67_1: LS67.1, U67.7 (OUTA)
OUT67_2: LS67.2, U67.5 (OUTB)
OUT68_1: LS68.1, U68.7 (OUTA)
OUT68_2: LS68.2, U68.5 (OUTB)
OUT69_1: LS69.1, U69.7 (OUTA)
OUT69_2: LS69.2, U69.5 (OUTB)
OUT70_1: LS70.1, U70.7 (OUTA)
OUT70_2: LS70.2, U70.5 (OUTB)
OUT71_1: LS71.1, U71.7 (OUTA)
OUT71_2: LS71.2, U71.5 (OUTB)
OUT72_1: LS72.1, U72.7 (OUTA)
OUT72_2: LS72.2, U72.5 (OUTB)
OUT73_1: LS73.1, U73.7 (OUTA)
OUT73_2: LS73.2, U73.5 (OUTB)
OUT74_1: LS74.1, U74.7 (OUTA)
OUT74_2: LS74.2, U74.5 (OUTB)
OUT75_1: LS75.1, U75.7 (OUTA)
OUT75_2: LS75.2, U75.5 (OUTB)
OUT76_1: LS76.1, U76.7 (OUTA)
OUT76_2: LS76.2, U76.5 (OUTB)
OUT77_1: LS77.1, U77.7 (OUTA)
OUT77_2: LS77.2, U77.5 (OUTB)
OUT78_1: LS78.1, U78.7 (OUTA)
OUT78_2: LS78.2, U78.5 (OUTB)
OUT79_1: LS79.1, U79.7 (OUTA)
OUT79_2: LS79.2, U79.5 (OUTB)
OUT80_1: LS80.1, U80.7 (OUTA)
OUT80_2: LS80.2, U80.5 (OUTB)
OUT81_1: LS81.1, U81.7 (OUTA)
OUT81_2: LS81.2, U81.5 (OUTB)
OUT82_1: LS82.1, U82.7 (OUTA)
OUT82_2: LS82.2, U82.5 (OUTB)
OUT83_1: LS83.1, U83.7 (OUTA)
OUT83_2: LS83.2, U83.5 (OUTB)
OUT84_1: LS84.1, U84.7 (OUTA)
OUT84_2: LS84.2, U84.5 (OUTB)
OUT85_1: LS85.1, U85.7 (OUTA)
OUT85_2: LS85.2, U85.5 (OUTB)
OUT86_1: LS86.1, U86.7 (OUTA)
OUT86_2: LS86.2, U86.5 (OUTB)
OUT87_1: LS87.1, U87.7 (OUTA)
OUT87_2: LS87.2, U87.5 (OUTB)
OUT88_1: LS88.1, U88.7 (OUTA)
OUT88_2: LS88.2, U88.5 (OUTB)
OUT89_1: LS89.1, U89.7 (OUTA)
OUT89_2: LS89.2, U89.5 (OUTB)
OUT90_1: LS90.1, U90.7 (OUTA)
OUT90_2: LS90.2, U90.5 (OUTB)
OUT91_1: LS91.1, U91.7 (OUTA)
OUT91_2: LS91.2, U91.5 (OUTB)
OUT92_1: LS92.1, U92.7 (OUTA)
OUT92_2: LS92.2, U92.5 (OUTB)
OUT93_1: LS93.1, U93.7 (OUTA)
OUT93_2: LS93.2, U93.5 (OUTB)
OUT94_1: LS94.1, U94.7 (OUTA)
OUT94_2: LS94.2, U94.5 (OUTB)
OUT95_1: LS95.1, U95.7 (OUTA)
OUT95_2: LS95.2, U95.5 (OUTB)
OUT96_1: LS96.1, U96.7 (OUTA)
OUT96_2: LS96.2, U96.5 (OUTB)
OUT97_1: LS97.1, U97.7 (OUTA)
OUT97_2: LS97.2, U97.5 (OUTB)
OUT98_1: LS98.1, U98.7 (OUTA)
OUT98_2: LS98.2, U98.5 (OUTB)
OUT99_1: LS99.1, U99.7 (OUTA)
OUT99_2: LS99.2, U99.5 (OUTB)
OUT100_1: LS100.1, U100.7 (OUTA)
OUT100_2: LS100.2, U100.5 (OUTB)
OUT101_1: LS101.1, U101.7 (OUTA)
OUT101_2: LS101.2, U101.5 (OUTB)
OUT102_1: LS102.1, U102.7 (OUTA)
OUT102_2: LS102.2, U102.5 (OUTB)
OUT103_1: LS103.1, U103.7 (OUTA)
OUT103_2: LS103.2, U103.5 (OUTB)
OUT104_1: LS104.1, U104.7 (OUTA)
OUT104_2: LS104.2, U104.5 (OUTB)
OUT105_1: LS105.1, U105.7 (OUTA)
OUT105_2: LS105.2, U105.5 (OUTB)
OUT106_1: LS106.1, U106.7 (OUTA)
OUT106_2: LS106.2, U106.5 (OUTB)
OUT107_1: LS107.1, U107.7 (OUTA)
OUT107_2: LS107.2, U107.5 (OUTB)
OUT108_1: LS108.1, U108.7 (OUTA)
OUT108_2: LS108.2, U108.5 (OUTB)
OUT109_1: LS109.1, U109.7 (OUTA)
OUT109_2: LS109.2, U109.5 (OUTB)
OUT110_1: LS110.1, U110.7 (OUTA)
OUT110_2: LS110.2, U110.5 (OUTB)
OUT111_1: LS111.1, U111.7 (OUTA)
OUT111_2: LS111.2, U111.5 (OUTB)
OUT112_1: LS112.1, U112.7 (OUTA)
OUT112_2: LS112.2, U112.5 (OUTB)
OUT113_1: LS113.1, U113.7 (OUTA)
OUT113_2: LS113.2, U113.5 (OUTB)
OUT114_1: LS114.1, U114.7 (OUTA)
OUT114_2: LS114.2, U114.5 (OUTB)
OUT115_1: LS115.1, U115.7 (OUTA)
OUT115_2: LS115.2, U115.5 (OUTB)
OUT116_1: LS116.1, U116.7 (OUTA)
OUT116_2: LS116.2, U116.5 (OUTB)
OUT117_1: LS117.1, U117.7 (OUTA)
OUT117_2: LS117.2, U117.5 (OUTB)
OUT118_1: LS118.1, U118.7 (OUTA)
OUT118_2: LS118.2, U118.5 (OUTB)
OUT119_1: LS119.1, U119.7 (OUTA)
OUT119_2: LS119.2, U119.5 (OUTB)
OUT120_1: LS120.1, U120.7 (OUTA)
OUT120_2: LS120.2, U120.5 (OUTB)
OUT121_1: LS121.1, U121.7 (OUTA)
OUT121_2: LS121.2, U121.5 (OUTB)
OUT122_1: LS122.1, U122.7 (OUTA)
OUT122_2: LS122.2, U122.5 (OUTB)
OUT123_1: LS123.1, U123.7 (OUTA)
OUT123_2: LS123.2, U123.5 (OUTB)
OUT124_1: LS124.1, U124.7 (OUTA)
OUT124_2: LS124.2, U124.5 (OUTB)
OUT125_1: LS125.1, U125.7 (OUTA)
OUT125_2: LS125.2, U125.5 (OUTB)
OUT126_1: LS126.1, U126.7 (OUTA)
OUT126_2: LS126.2, U126.5 (OUTB)
OUT127_1: LS127.1, U127.7 (OUTA)
OUT127_2: LS127.2, U127.5 (OUTB)
OUT128_1: LS128.1, U128.7 (OUTA)
OUT128_2: LS128.2, U128.5 (OUTB)
OUT129_1: LS129.1, U129.7 (OUTA)
OUT129_2: LS129.2, U129.5 (OUTB)
OUT130_1: LS130.1, U130.7 (OUTA)
OUT130_2: LS130.2, U130.5 (OUTB)
OUT131_1: LS131.1, U131.7 (OUTA)
OUT131_2: LS131.2, U131.5 (OUTB)
OUT132_1: LS132.1, U132.7 (OUTA)
OUT132_2: LS132.2, U132.5 (OUTB)
OUT133_1: LS133.1, U133.7 (OUTA)
OUT133_2: LS133.2, U133.5 (OUTB)
OUT134_1: LS134.1, U134.7 (OUTA)
OUT134_2: LS134.2, U134.5 (OUTB)
OUT135_1: LS135.1, U135.7 (OUTA)
OUT135_2: LS135.2, U135.5 (OUTB)
OUT136_1: LS136.1, U136.7 (OUTA)
OUT136_2: LS136.2, U136.5 (OUTB)
OUT137_1: LS137.1, U137.7 (OUTA)
OUT137_2: LS137.2, U137.5 (OUTB)
OUT138_1: LS138.1, U138.7 (OUTA)
OUT138_2: LS138.2, U138.5 (OUTB)
OUT139_1: LS139.1, U139.7 (OUTA)
OUT139_2: LS139.2, U139.5 (OUTB)
OUT140_1: LS140.1, U140.7 (OUTA)
OUT140_2: LS140.2, U140.5 (OUTB)
OUT141_1: LS141.1, U141.7 (OUTA)
OUT141_2: LS141.2, U141.5 (OUTB)
OUT142_1: LS142.1, U142.7 (OUTA)
OUT142_2: LS142.2, U142.5 (OUTB)
OUT143_1: LS143.1, U143.7 (OUTA)
OUT143_2: LS143.2, U143.5 (OUTB)
OUT144_1: LS144.1, U144.7 (OUTA)
OUT144_2: LS144.2, U144.5 (OUTB)
RCLK: A2.6 (J5-6 IO41), U145.12 (RCLK), U146.12 (RCLK), U147.12 (RCLK), U148.12 (RCLK), U149.12 (RCLK), U150.12 (RCLK), U151.12 (RCLK), U152.12 (RCLK), U153.12 (RCLK), U154.12 (RCLK), U155.12 (RCLK), U156.12 (RCLK), U157.12 (RCLK), U158.12 (RCLK), U159.12 (RCLK), U160.12 (RCLK), U161.12 (RCLK), U162.12 (RCLK)
SER1: A2.21 (J6-1 IO73), U145.14 (SER)
SER2: A2.22 (J6-2 IO74), U148.14 (SER)
SER3: A2.18 (J5-18 IO71), U151.14 (SER)
SER4: A2.17 (J5-17 IO72), U154.14 (SER)
SER5: A2.4 (J5-4 IO80), U157.14 (SER)
SER6: A2.24 (J6-4 IO85), U160.14 (SER)
SPI_CE0: A1.24 (CE0 GPIO8), A2.29 (J6-9 IO28), R1.2
SPI_CE1: A1.26 (CE1 GPIO7), A2.32 (J6-12 IO29), J6.3, R2.2
SPI_MOSI: A1.19 (MOSI GPIO10), A2.28 (J6-8 IO27), J6.1
SPI_SCLK: A1.23 (SCLK GPIO11), A2.25 (J6-5 IO77), J6.2
SRCLK: A2.5 (J5-5 IO42), U145.11 (SRCLK), U146.11 (SRCLK), U147.11 (SRCLK), U148.11 (SRCLK), U149.11 (SRCLK), U150.11 (SRCLK), U151.11 (SRCLK), U152.11 (SRCLK), U153.11 (SRCLK), U154.11 (SRCLK), U155.11 (SRCLK), U156.11 (SRCLK), U157.11 (SRCLK), U158.11 (SRCLK), U159.11 (SRCLK), U160.11 (SRCLK), U161.11 (SRCLK), U162.11 (SRCLK)
SRQ0: U145.9 (QH'), U146.14 (SER)
SRQ1: U146.9 (QH'), U147.14 (SER)
SRQ3: U148.9 (QH'), U149.14 (SER)
SRQ4: U149.9 (QH'), U150.14 (SER)
SRQ6: U151.9 (QH'), U152.14 (SER)
SRQ7: U152.9 (QH'), U153.14 (SER)
SRQ9: U154.9 (QH'), U155.14 (SER)
SRQ10: U155.9 (QH'), U156.14 (SER)
SRQ12: U157.9 (QH'), U158.14 (SER)
SRQ13: U158.9 (QH'), U159.14 (SER)
SRQ15: U160.9 (QH'), U161.14 (SER)
SRQ16: U161.9 (QH'), U162.14 (SER)
SYNC: A2.33 (J6-13 IO30), R3.1
SYNC_LINK: J6.4, R3.2

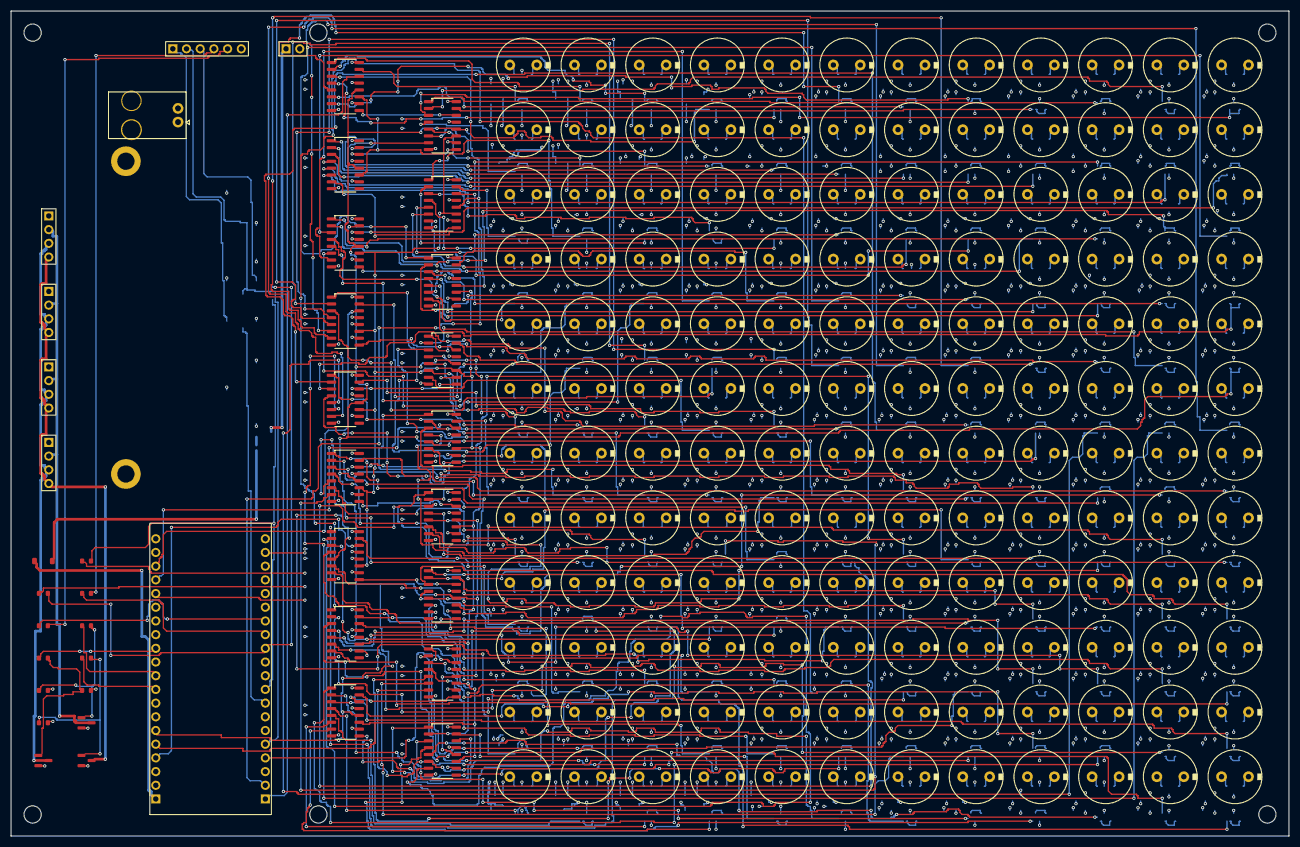
[picture p2: board AV3D PC.kicad_pcb from above]

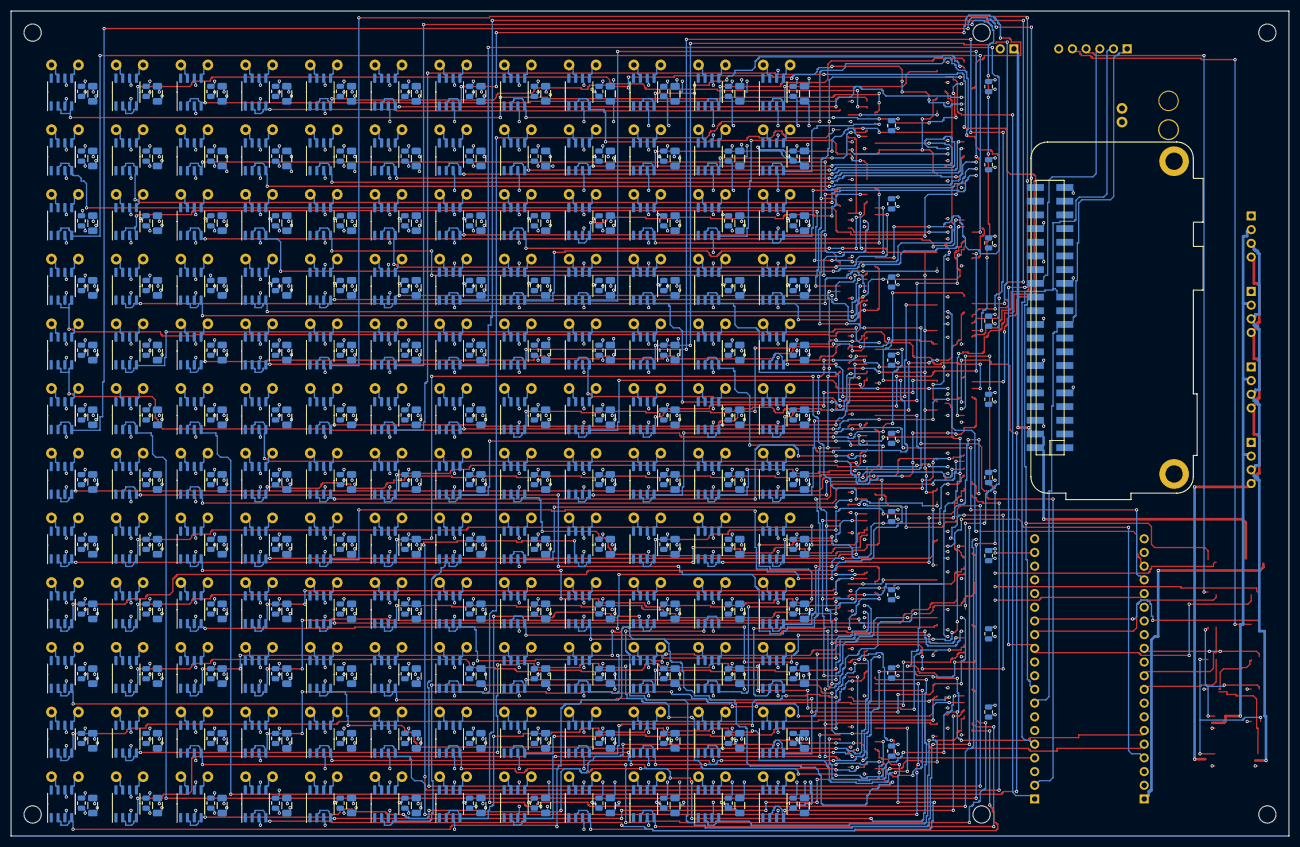
[picture p3: board AV3D PC.kicad_pcb from below]

Board: 4 copper layers, 237.0 x 153.0 mm, 641 parts (451 on the bottom side), 474 nets.

Other parts of the board:
H1, H2, H3, H4, H5, H6: MountingHole; MountingHole_3.2mm_M3
