CanadianOrca/AV3D/(commit log)

2026-11-02 Remove old Pico template
2026-11-02 added design notes and space for prototype notes.
2026-11-12 Add README, build script, and pin constraint files for FPGA firmware, testbenches n/a
2026-11-12 cad file upload (prototype)
    [Hackclub Avid protoype model.step, Hackclubprototype.step]
2026-11-12 Delete cad/Hackclub Avid protoype model.step
    copy extra not needed (Hackclubprototype.step)
    [Hackclub Avid protoype model.step]
2026-11-12 PCB submission files Kicad
    [AV3D PC.kicad_pcb, AV3D PCB.kicad_sch]
2026-11-12 kicad file organization and gerber upload
    [AV3D PC.kicad_pcb, AV3D PCB.kicad_sch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]
2026-11-12 create bom.csv (bill of materials)
    [bom.csv]
